wagdymohamed14/Air-powered-vehicle/WhatsApp Image 2026-02-13 at 14.18.36.jpeg

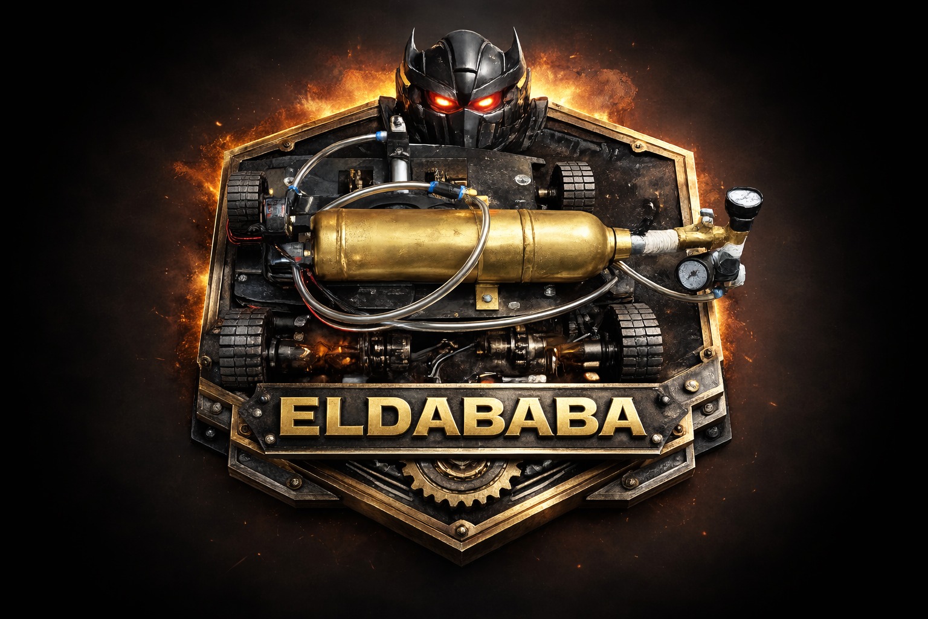
WhatsApp Image 2026-02-13 at 14.18.36.jpeg
