wagdymohamed14/Air-powered-vehicle/ELDBABA.png

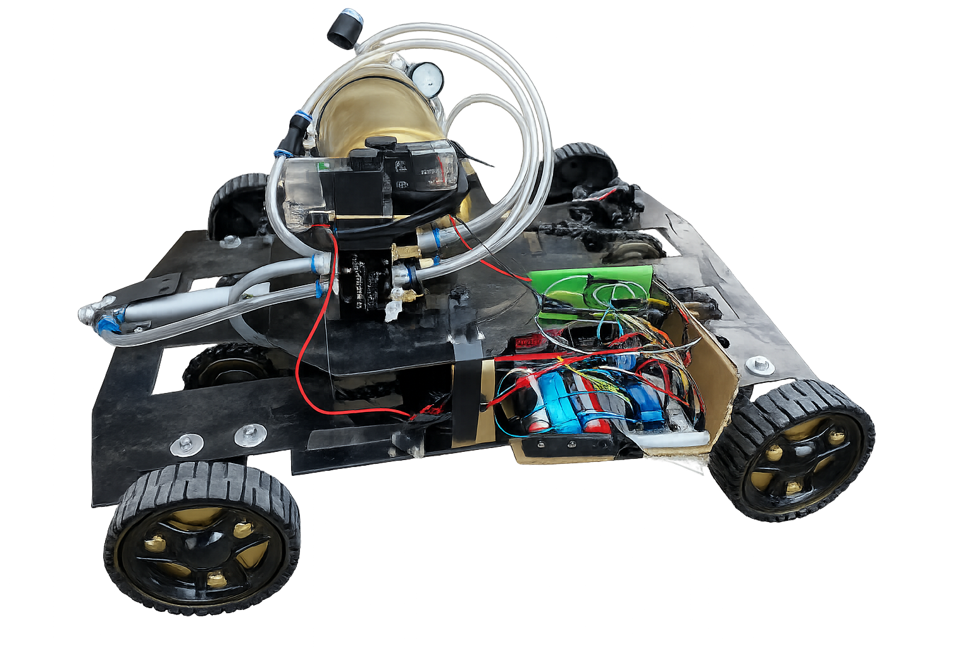
ELDBABA.png
