wagdymohamed14/Air-powered-vehicle/DABABA2.png

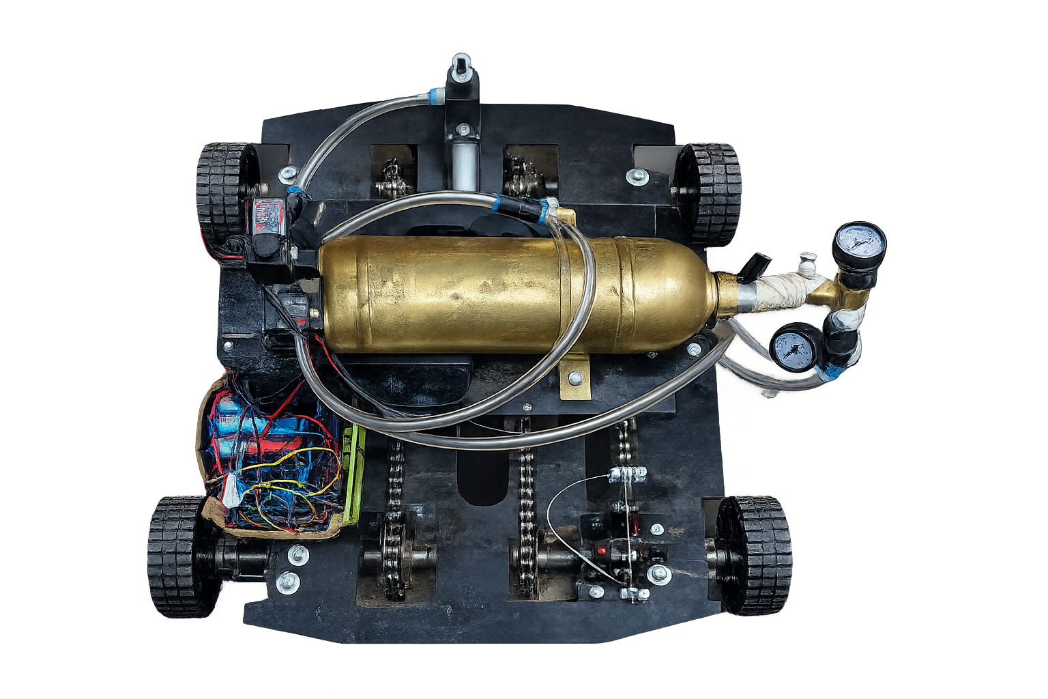
DABABA2.png
