wagdymohamed14/Air-powered-vehicle/face.dxf

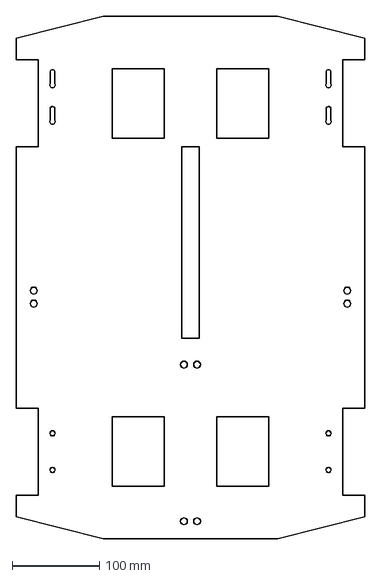
[picture p15: CAD file, 2026-02-13]
face.dxf
400.0 x 600.0 mm
