wagdymohamed14/Air-powered-vehicle/kkkk.dxf

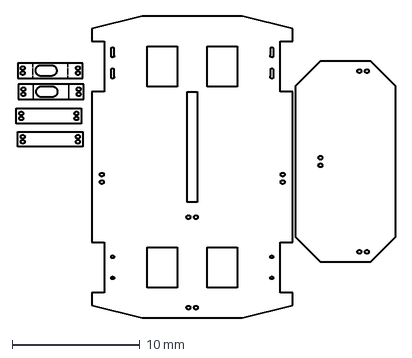
[picture p16: CAD file, 2026-02-13]
kkkk.dxf
29.8 x 23.6 mm
