wagdymohamed14/Air-powered-vehicle/(list of files, cad)

Other CAD files:
bracket up.dwg
chain piston adaptor.dwg
face up.dwg
chassis.dwg
piston bracke11t.dwg
pisss.dwg
lab 3.dxf
Assembly shaft 1 sprocect.iam
Assembly1.iam
Assembly1nwe.iam
Assembly8.iam
Assemblyfree gear.iam
Assemblyfull one piston.iam
Assemblyfull one piston111.iam
Assemblyfull two pistons .iam
Assemblyfull.iam
Part23.ipt
chain piston adaptor.ipt
chain.iam
chassis up .ipt
chassis.ipt
face.dwg
free gear shaft.ipt
full Assembly new.iam
kkkk.dwg
lab 3.dwg
piston bracke11t.ipt
piston bracket.ipt
shaft assembly.iam
shaft.ipt
sprocet adaptor.ipt
sprocet adaptor2 - Copy.ipt
sprocet adaptor2.ipt
tank.ipt
up bracket.ipt
